TOLDOTECHNIK/BLE-Quiz-Buzzer/docs/board-back.jpg

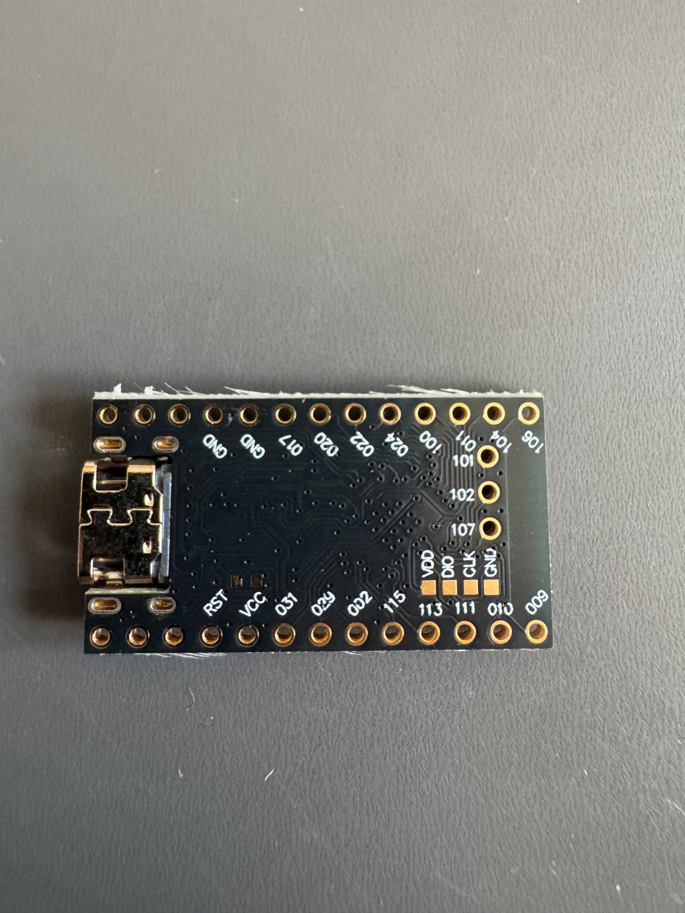
docs/board-back.jpg
