TOLDOTECHNIK/BLE-Quiz-Buzzer/docs/board-front.jpg

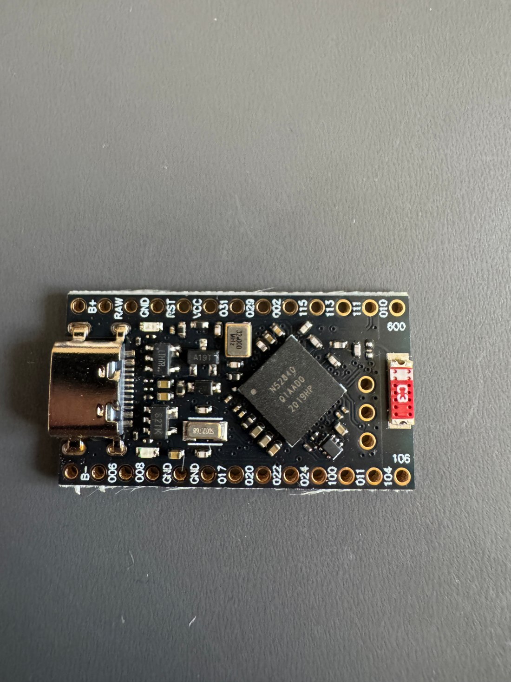
docs/board-front.jpg
