TOLDOTECHNIK/BLE-Quiz-Buzzer/3D Print Case/Body.stl

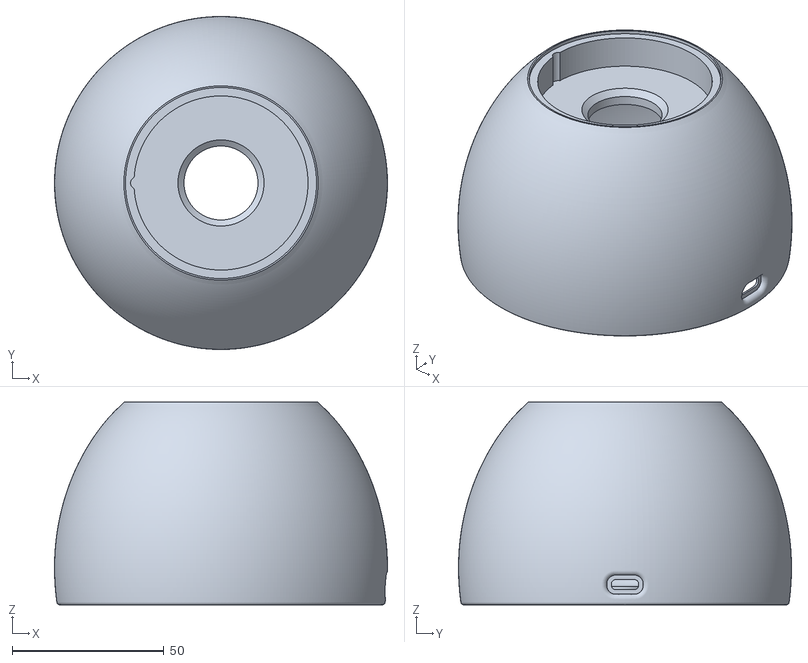
[picture p5: CAD file, 2026-10-12]
3D Print Case/Body.stl
109.8 x 109.8 x 66.8
