TOLDOTECHNIK/BLE-Quiz-Buzzer/3D Print Case/Bottom Plate.stl

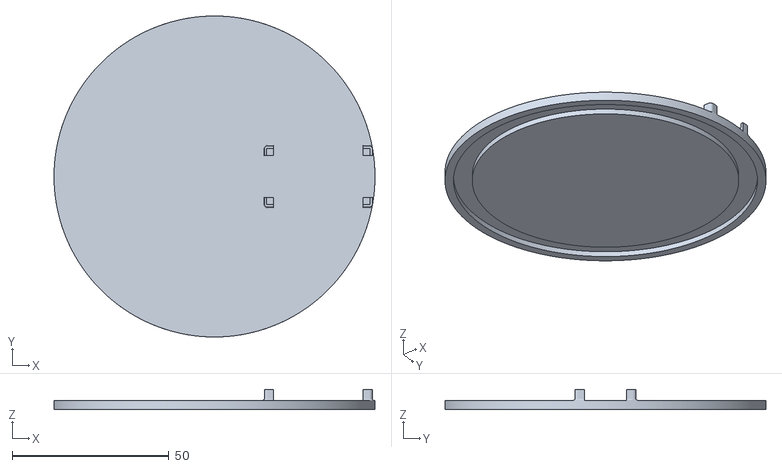
[picture p6: CAD file, 2026-10-12]
3D Print Case/Bottom Plate.stl
102.4 x 102.4 x 6.50
