TOLDOTECHNIK/BLE-Quiz-Buzzer/3D Print Case/Rubber Pad.stl

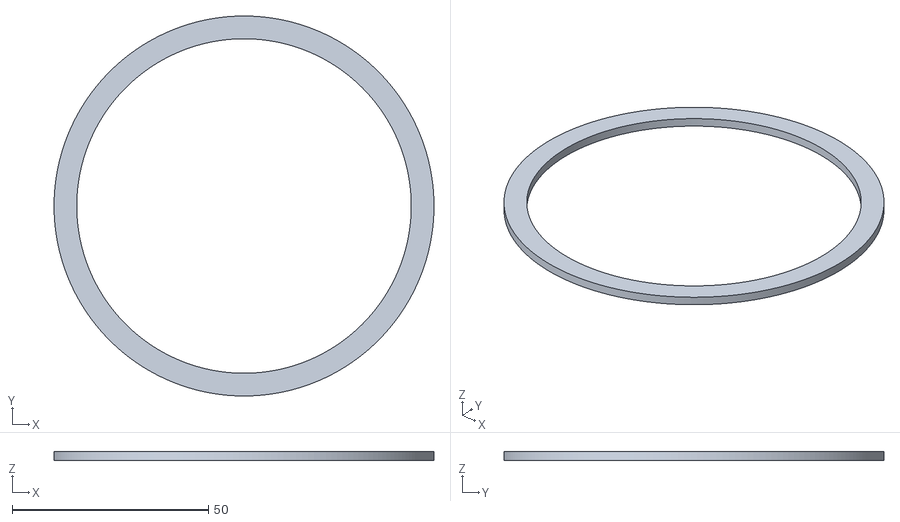
[picture p7: CAD file, 2026-10-12]
3D Print Case/Rubber Pad.stl
96.8 x 96.8 x 2.20
